davidlake/RC-Aerobatic-Acquisition-System/Desktop App/Images/FlightTrack.png

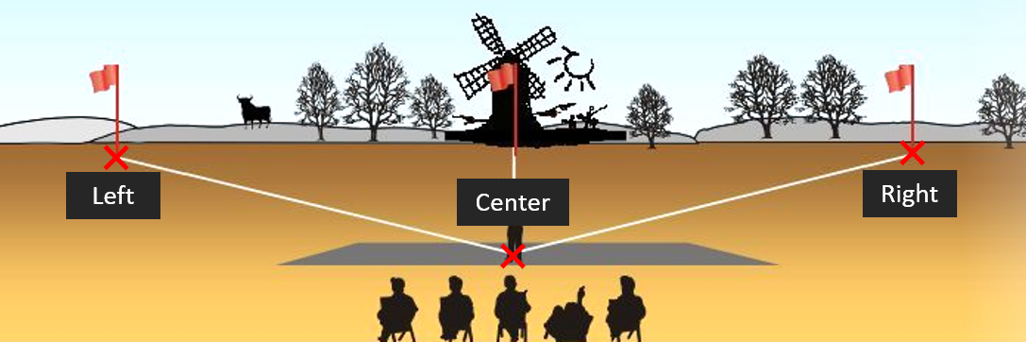
Desktop App/Images/FlightTrack.png
