davidlake/RC-Aerobatic-Acquisition-System/README.md

# RC-Aerobatic-Acquisition-System
System to determine orientation and position of aerobatic RC models
