davidlake/RC-Aerobatic-Acquisition-System/Envelope/Documentation plastic screws/Links.txt

https://webcatalog.epidor.com/es/category/tornillo-rosca-para-plastico-id-36751
https://www.indexfix.com/docs/FT_ROS_es.pdf
