davidlake/RC-Aerobatic-Acquisition-System/Components datasheets/Bluetooth HC06/Schematics/Schematic.PNG

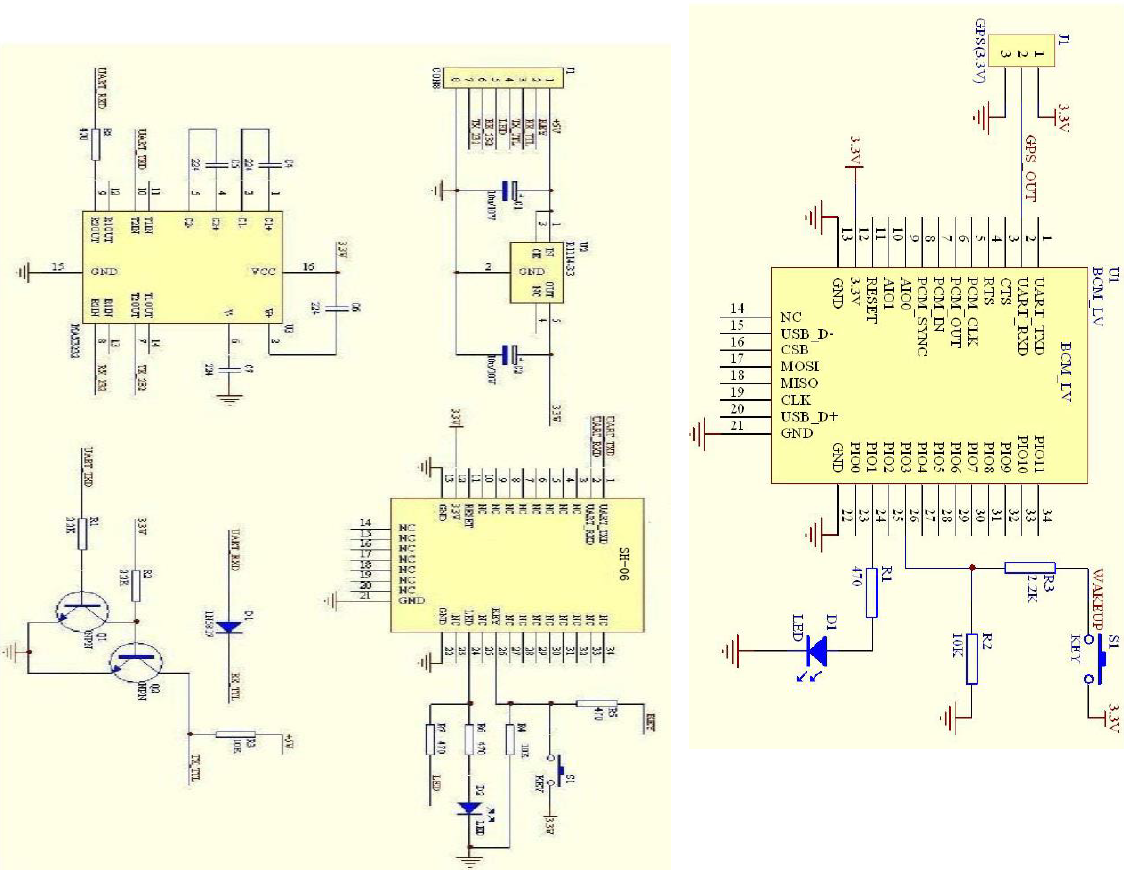
Components datasheets/Bluetooth HC06/Schematics/Schematic.PNG
