davidlake/RC-Aerobatic-Acquisition-System/Components datasheets/ublox NEO M8N/Schematic/Schematic modulo.PNG

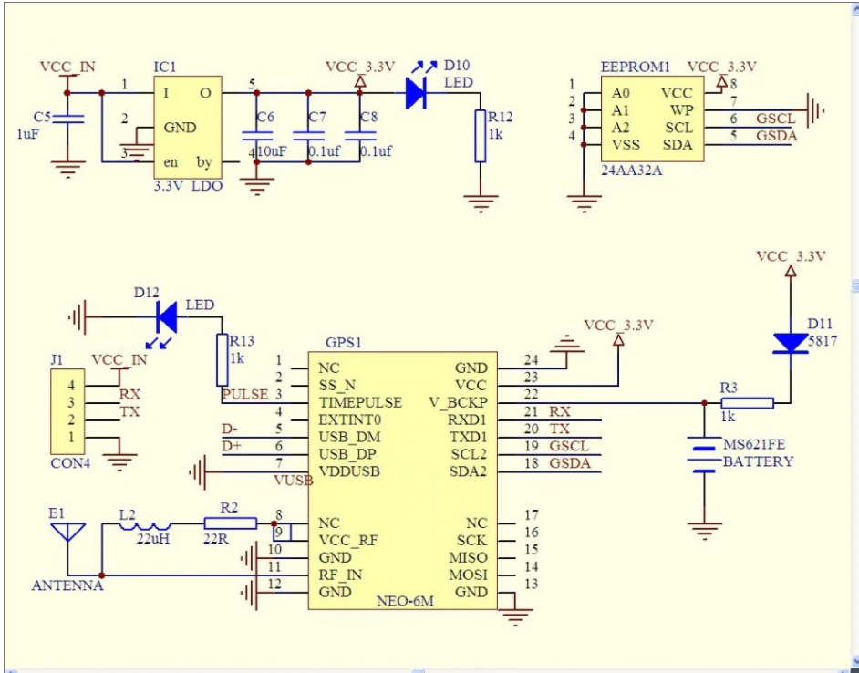
Components datasheets/ublox NEO M8N/Schematic/Schematic modulo.PNG
