davidlake/RC-Aerobatic-Acquisition-System/Components datasheets/W25Q64V/Pinout.JPG

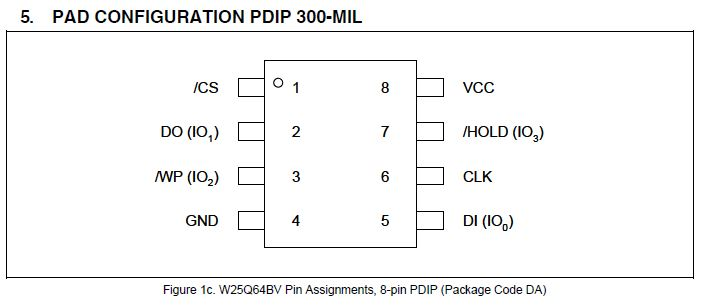
Components datasheets/W25Q64V/Pinout.JPG
