davidlake/RC-Aerobatic-Acquisition-System/Components datasheets/GY-63 MS5611/General info.JPG

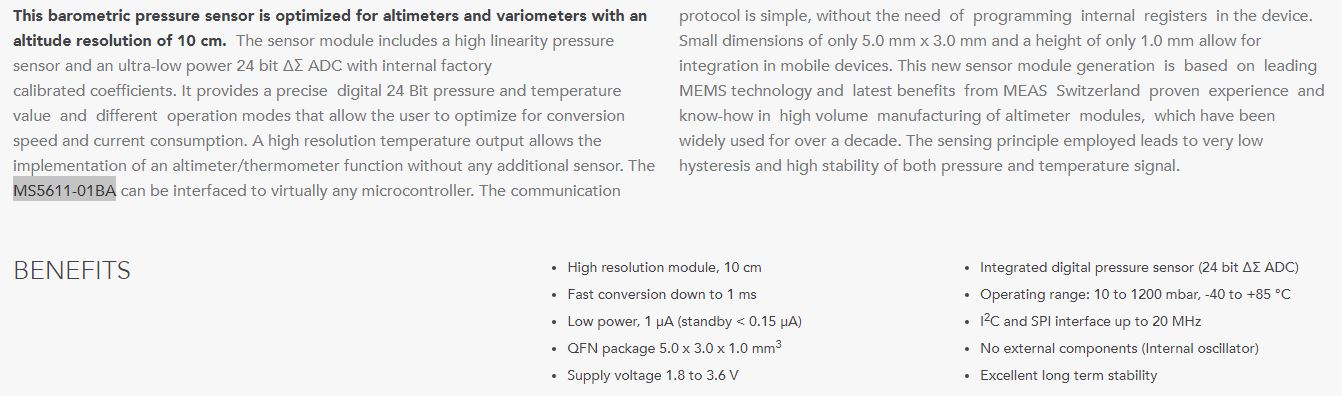
Components datasheets/GY-63 MS5611/General info.JPG
