davidlake/RC-Aerobatic-Acquisition-System/Components datasheets/W25Q64V/Pin description.JPG

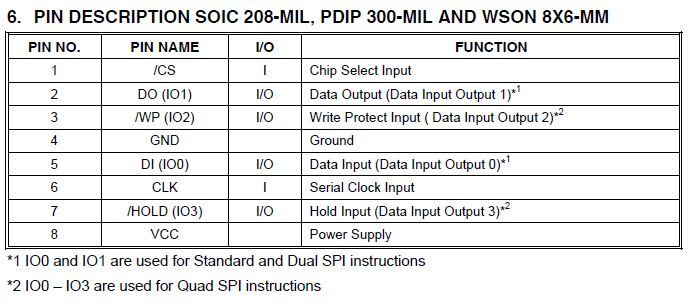
Components datasheets/W25Q64V/Pin description.JPG
