davidlake/RC-Aerobatic-Acquisition-System/Envelope/3D models/Assembly.step

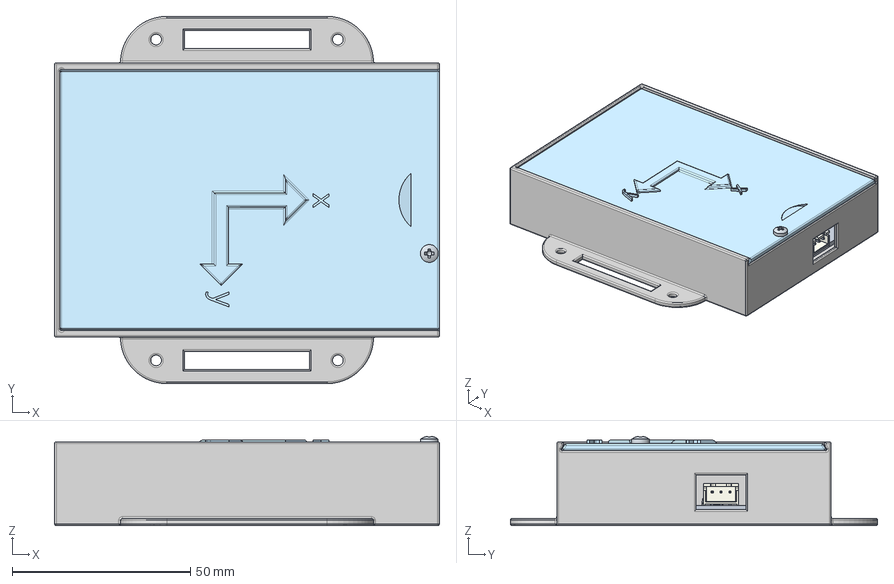
[picture p10: CAD file, 2021-08-31]
Envelope/3D models/Assembly.step
108.0 x 103.0 x 25.0 mm
PZ Pan head screw M2.5x0.45 x 4 x 5
Cap
Envelope box
