davidlake/RC-Aerobatic-Acquisition-System/Desktop App/AircraftModels/Gemini.stl

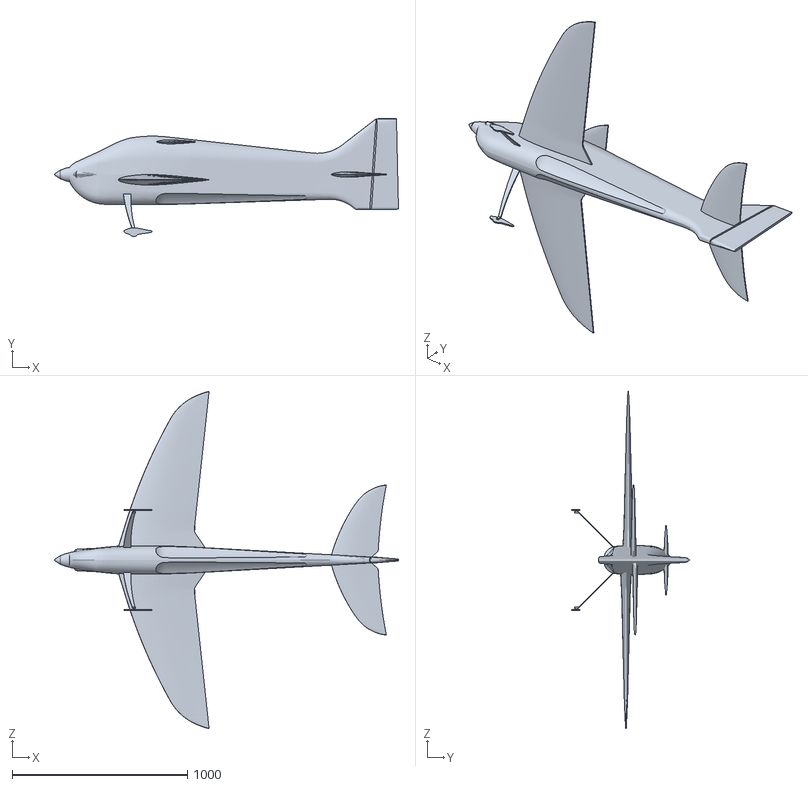
[picture p11: CAD file, 2021-09-01]
Desktop App/AircraftModels/Gemini.stl
1965.1 x 674.1 x 1928.2
