davidlake/RC-Aerobatic-Acquisition-System/Desktop App/Functions/STLRead/femur.stl

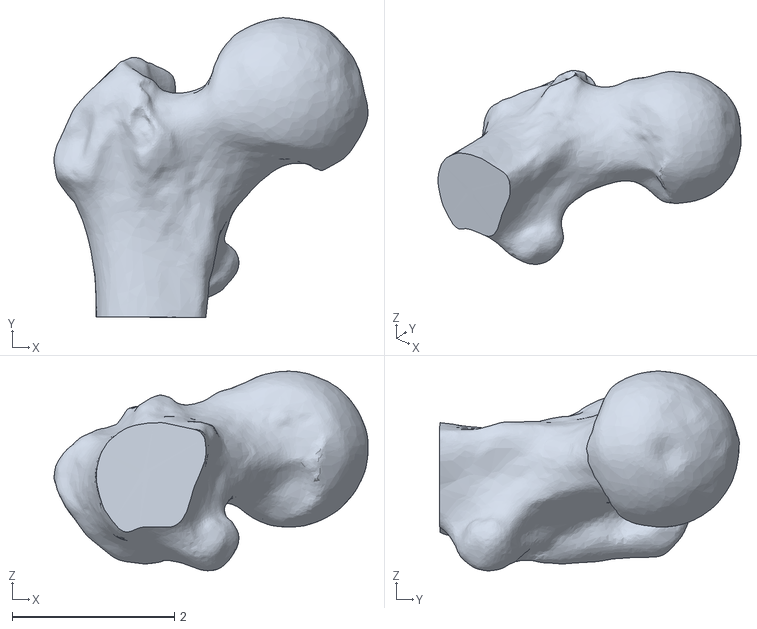
[picture p12: CAD file, 2021-08-28]
Desktop App/Functions/STLRead/femur.stl
3.87 x 3.70 x 2.46
