davidlake/RC-Aerobatic-Acquisition-System/Desktop App/UserData/AircraftModels/Aircraft surface.stl

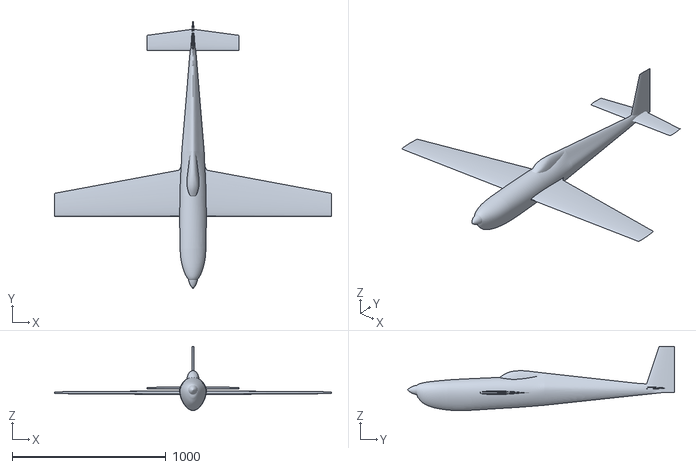
[picture p13: CAD file, 2021-08-28]
Desktop App/UserData/AircraftModels/Aircraft surface.stl
1800.0 x 1735.0 x 417.2
