davidlake/RC-Aerobatic-Acquisition-System/Envelope/3D models/Cap.step

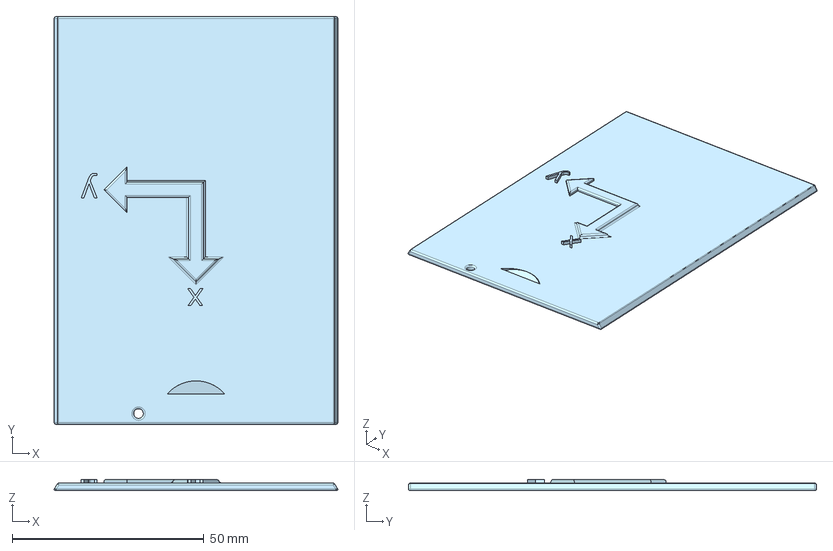
[picture p14: CAD file, 2021-08-31]
Envelope/3D models/Cap.step
74.1 x 106.5 x 3.00 mm
