davidlake/RC-Aerobatic-Acquisition-System/Hardware/F3A_Board.step

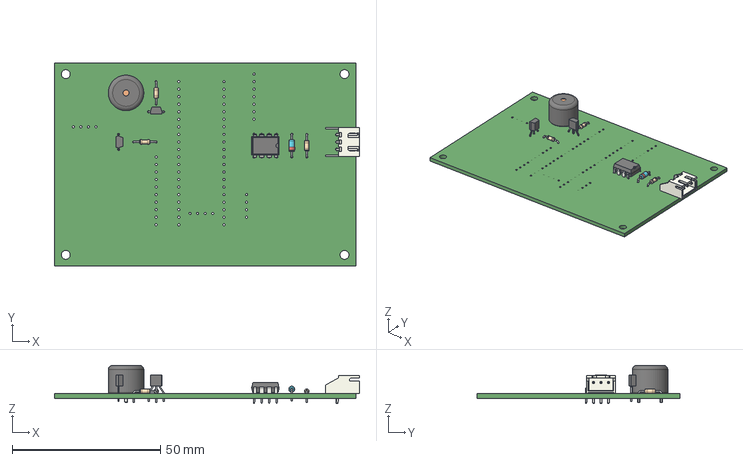
[picture p15: CAD file, 2021-08-26]
Hardware/F3A_Board.step
102.8 x 68.6 x 12.9 mm
