davidlake/RC-Aerobatic-Acquisition-System/Envelope/3D models/Envelope box.step

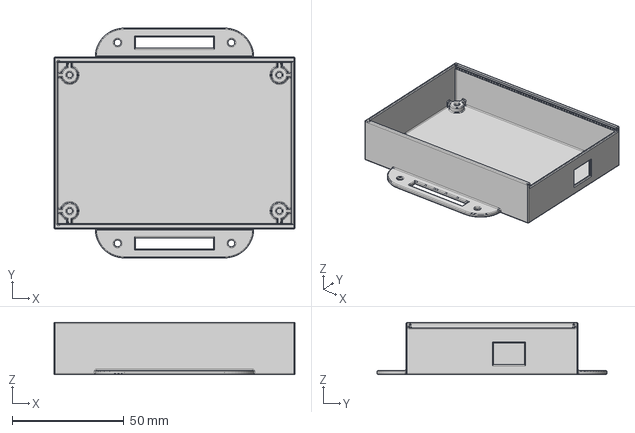
[picture p16: CAD file, 2021-08-31]
Envelope/3D models/Envelope box.step
108.0 x 103.0 x 23.5 mm
