davidlake/RC-Aerobatic-Acquisition-System/Hardware/Plots/F3A_Board.pdf

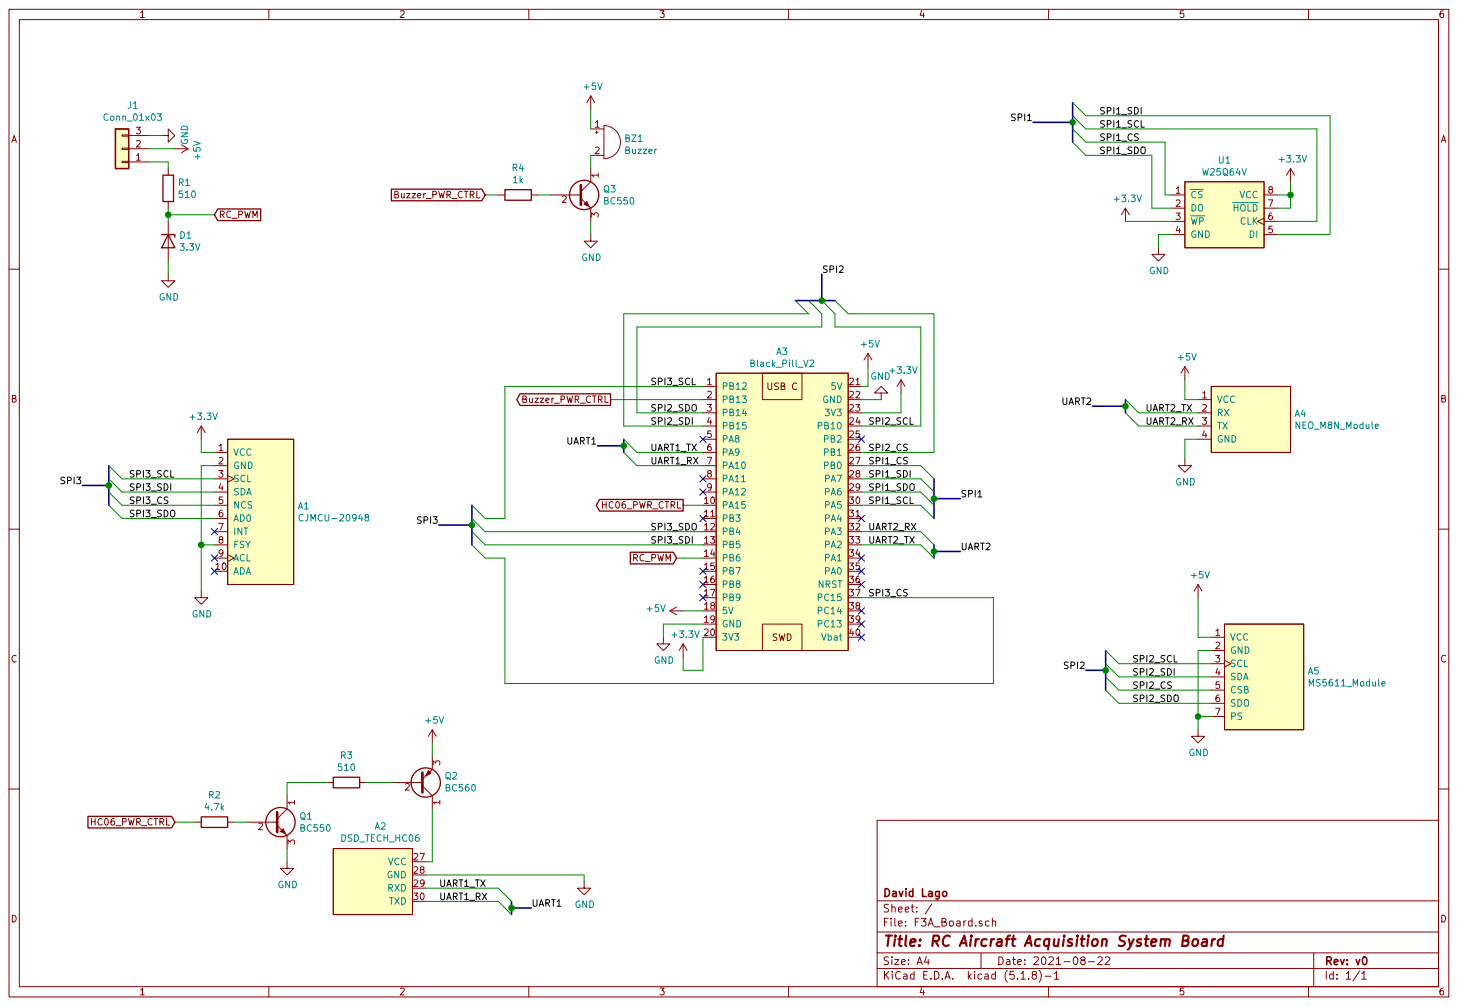
[picture p17: page 1]

File: F3A_Board.sch Sheet: / David Lago

Id: 1/1 Title: RC Aircraft Acquisition System Board
