davidlake/RC-Aerobatic-Acquisition-System/Envelope/Drawings/Assembly.pdf

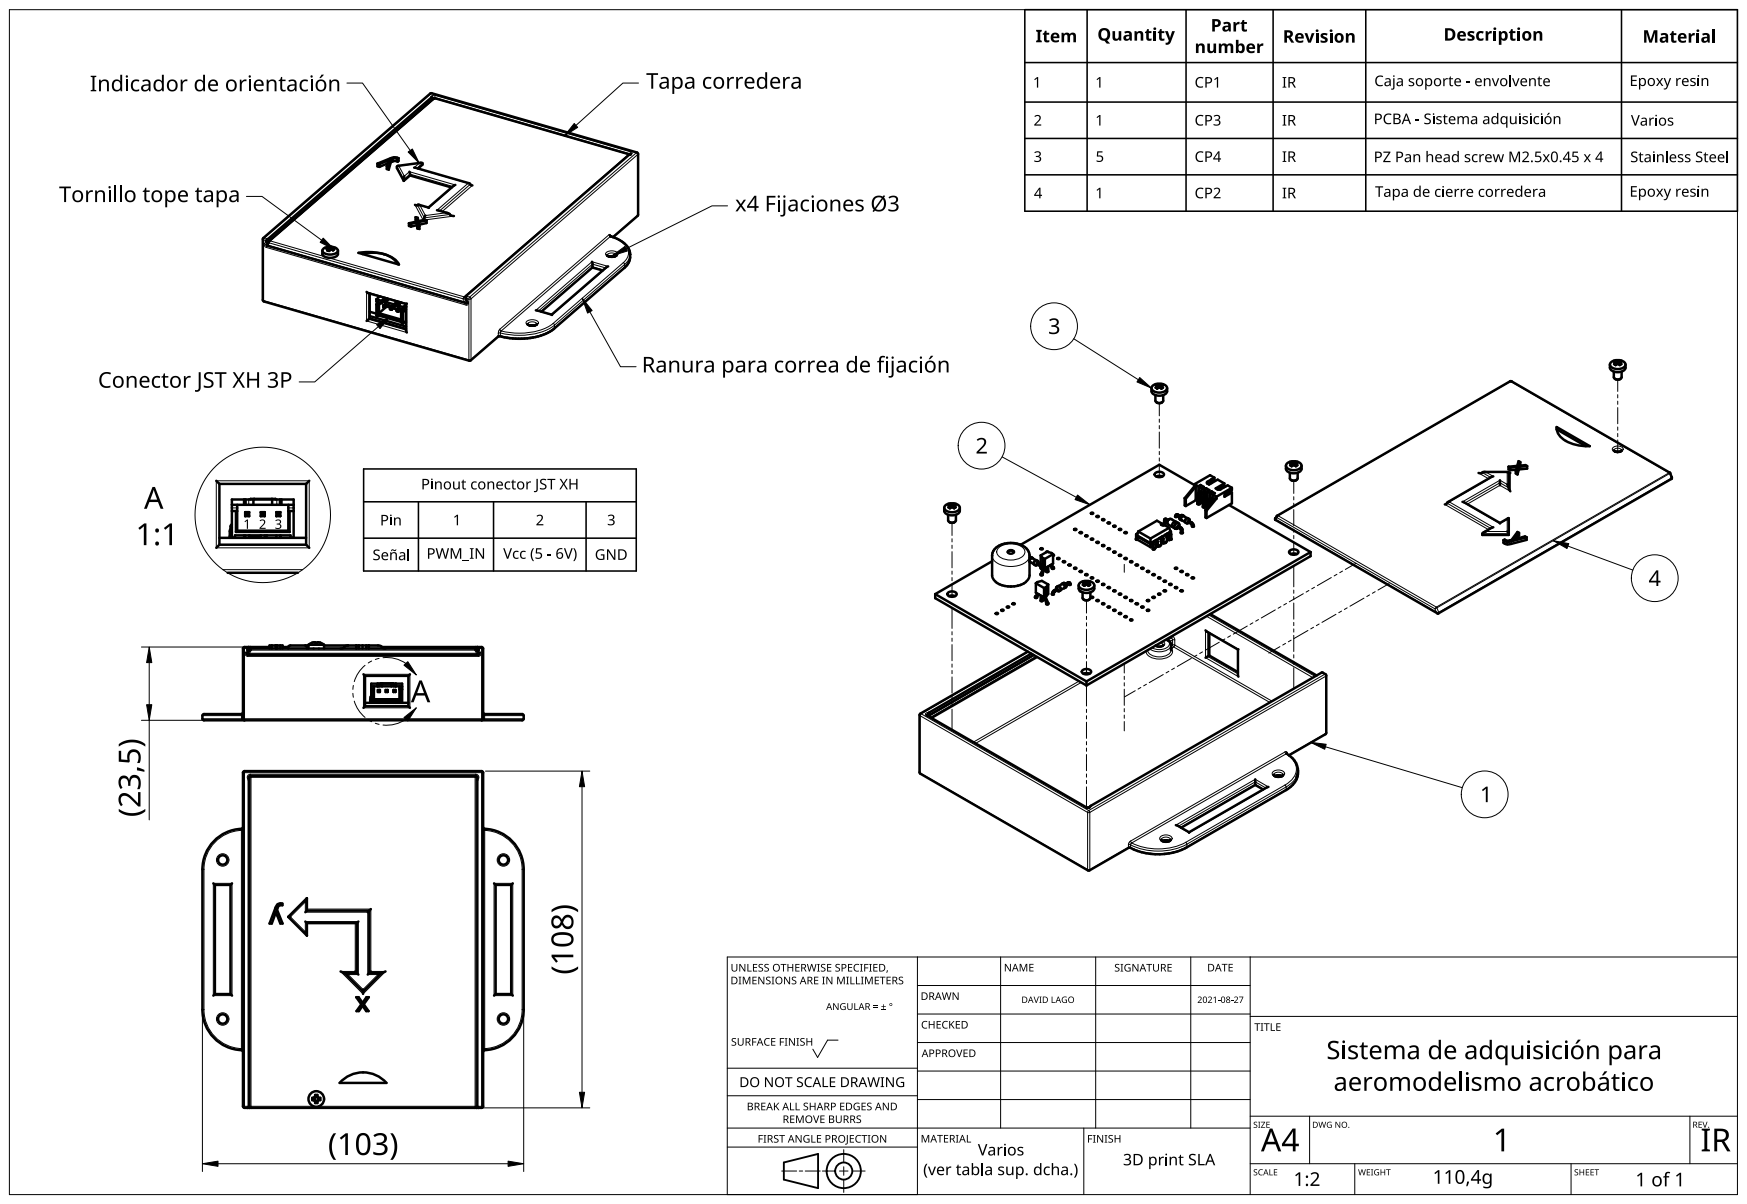
[picture p18: page 1]
