davidlake/RC-Aerobatic-Acquisition-System/Envelope/Drawings/Cap.pdf

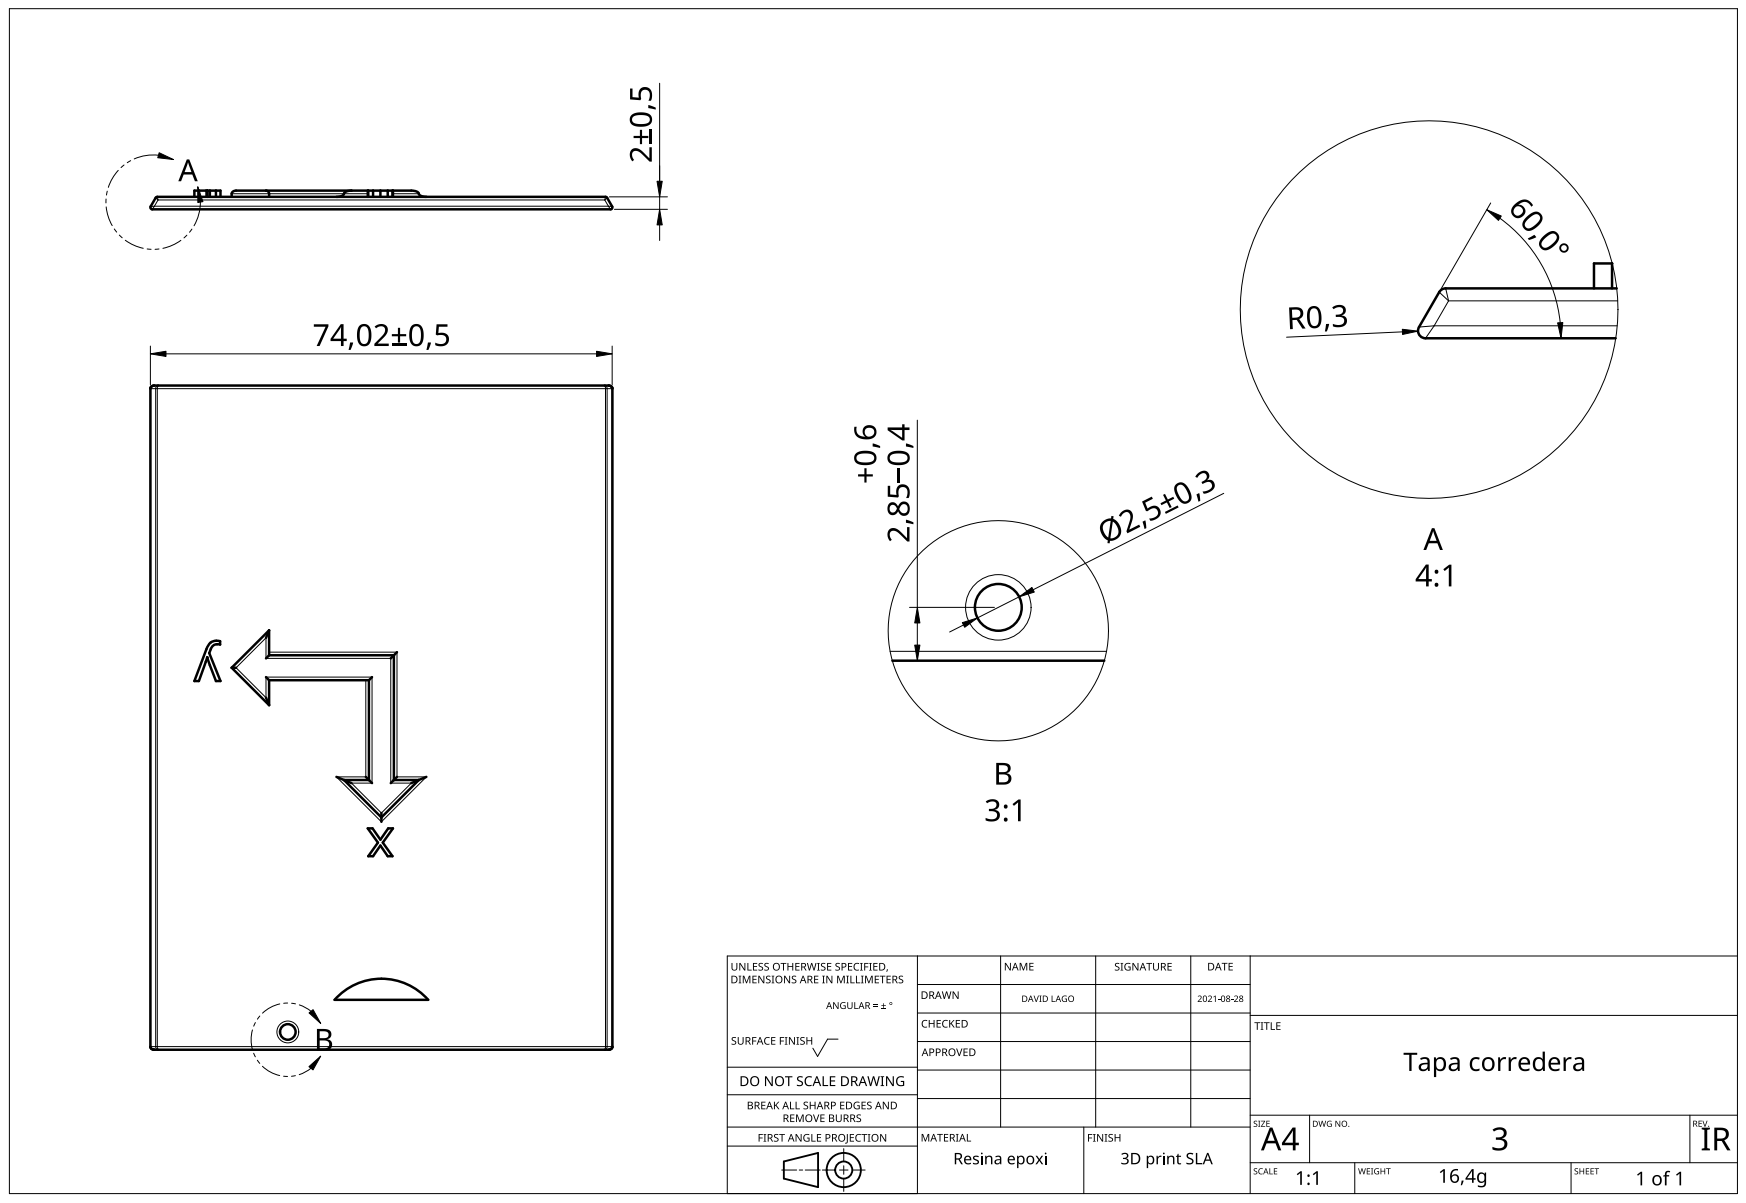
[picture p19: page 1]
