davidlake/RC-Aerobatic-Acquisition-System/Envelope/Drawings/Envelope box.pdf

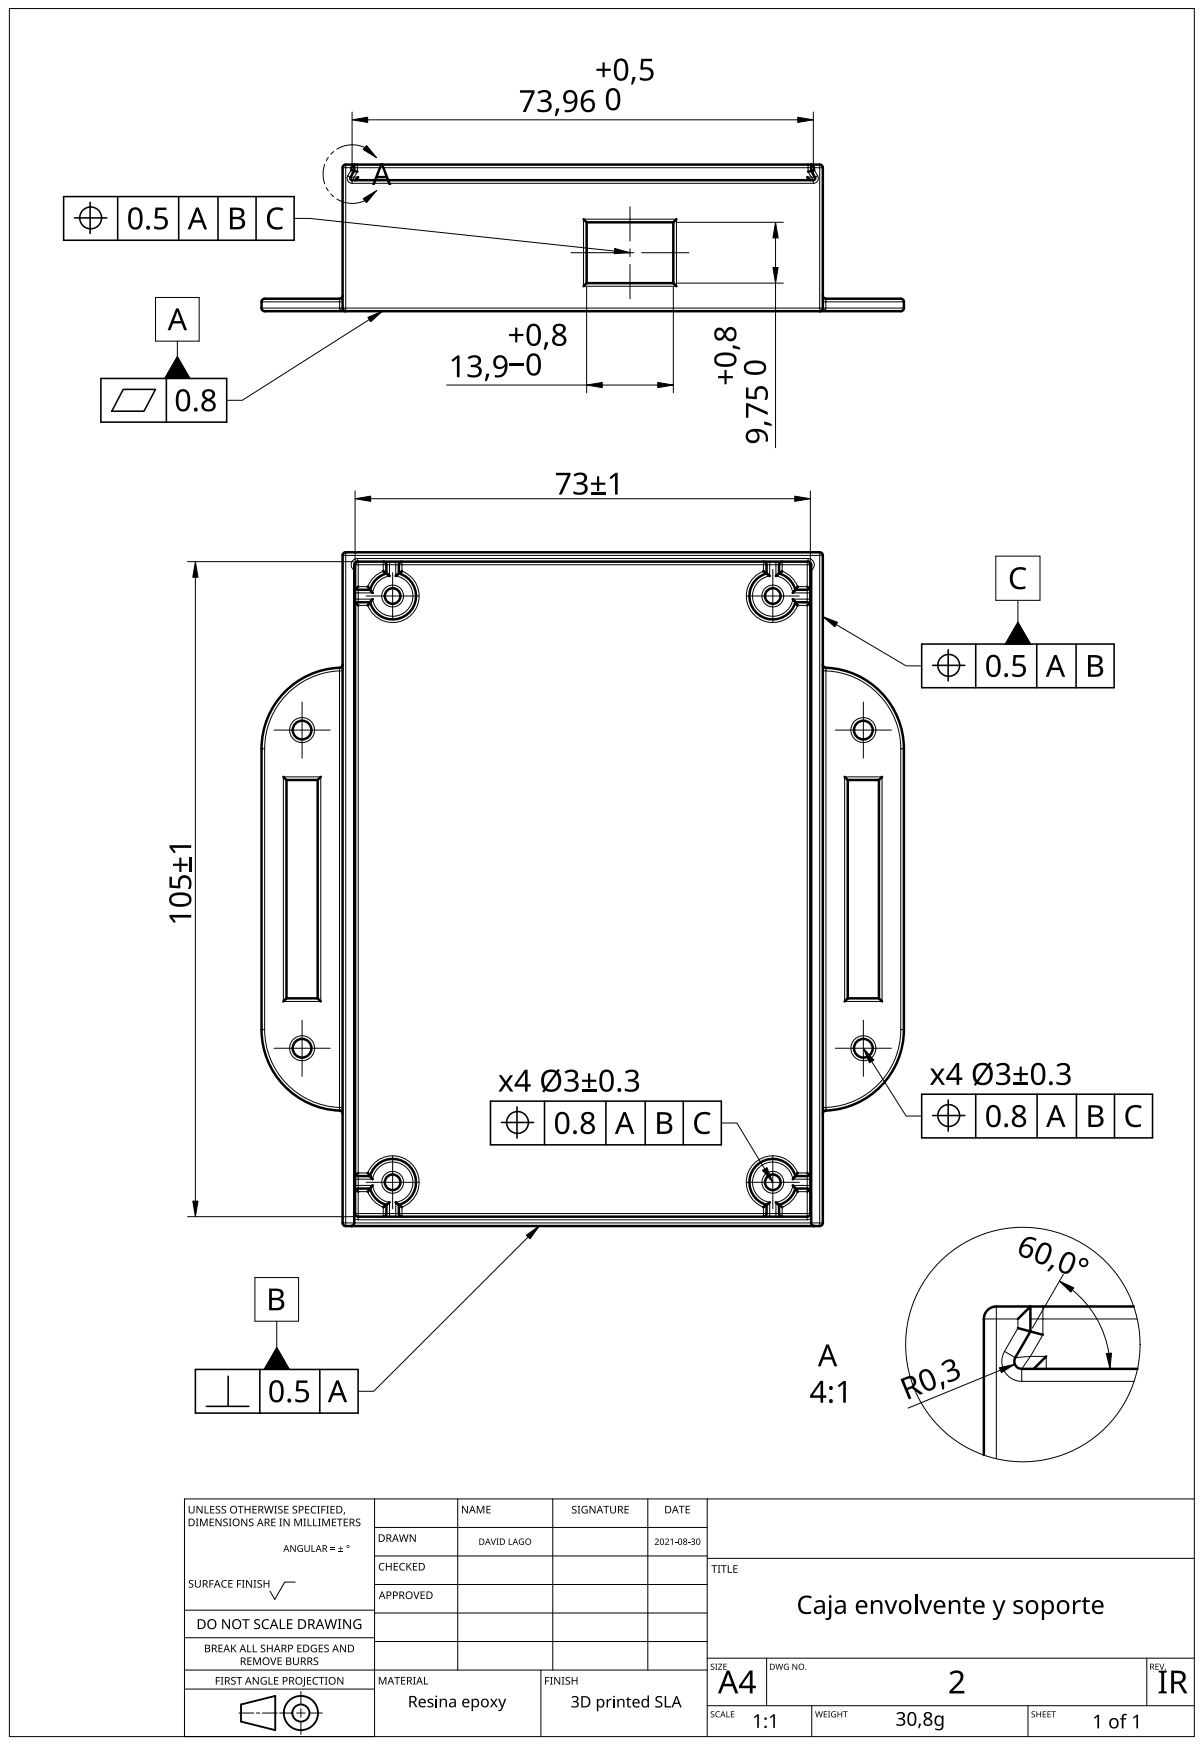
[picture p20: page 1]
