davidlake/RC-Aerobatic-Acquisition-System/Spice simulation/HC06_npn_pnp.asc

BC556B: pnp
Q1: npn; BC550C
R1: res; 510
R2: res; 4700
R3: res; 125
V1: voltage; 3.3
V2: voltage; 5
Named nets: 0
.tran 2
.lib C:\\Users\\dlago\\Documents\\LTspiceXVII\\lib\\europe.lib
