davidlake/RC-Aerobatic-Acquisition-System/Hardware/F3A_Board.kicad_pcb

## KiCad design Hardware/F3A_Board.kicad_pcb (2021-08-27)

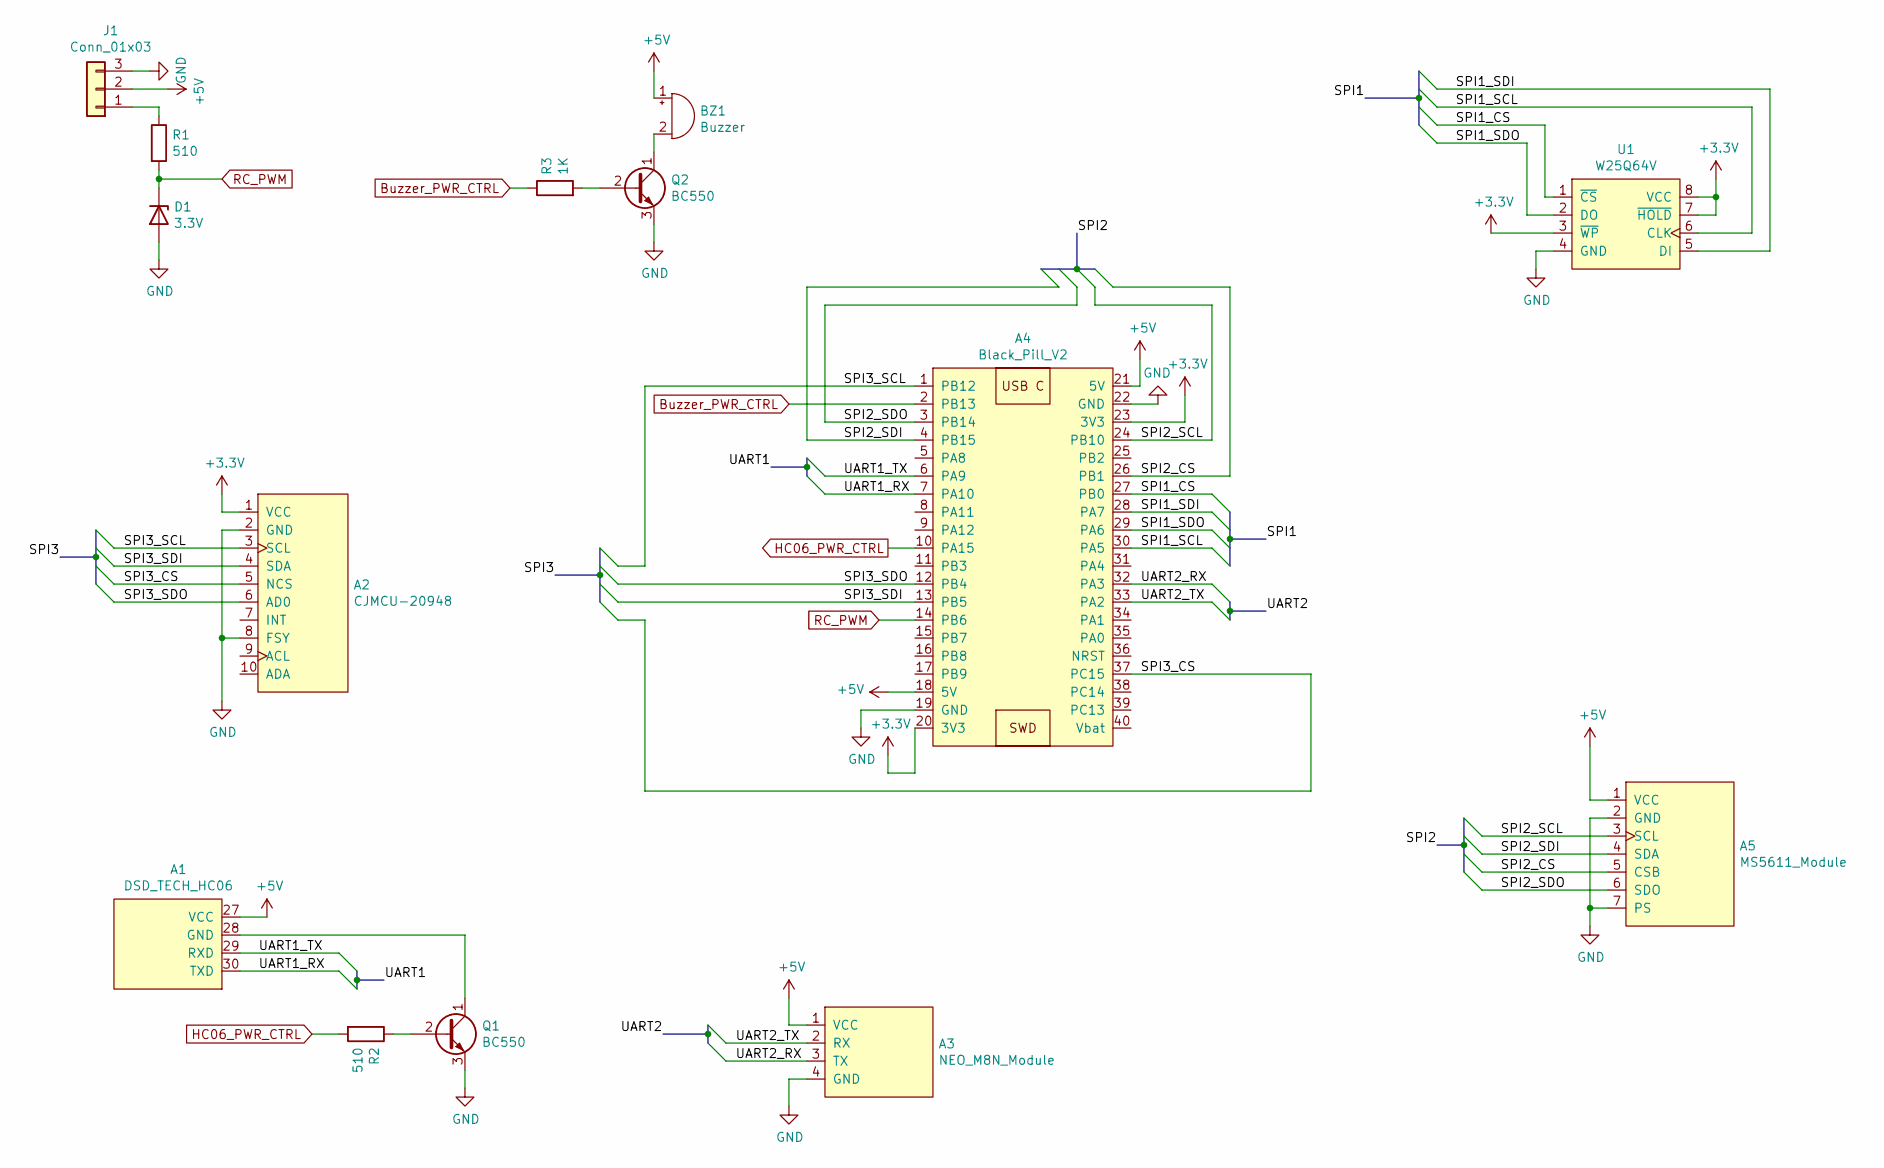
[picture p21: schematic F3A_Board.sch, RC Aircraft Acquisition System Board]

Parts:
A1: DSD_TECH_HC06
A2: CJMCU-20948; CJMCU_20948
A3: NEO_M8N_Module
A4: Black_Pill_V2
A5: MS5611_Module
BZ1: Buzzer; Buzzer_12x9.5RM7.6
D1: 3.3V; D_DO-35_SOD27_P7.62mm_Horizontal
J1: Conn_01x03; JST_XH_S3B-XH-A-1_1x03_P2.50mm_Horizontal
Q1, Q2: BC550; TO-92S_Wide
R1, R2: 510; R_Axial_DIN0204_L3.6mm_D1.6mm_P7.62mm_Horizontal
R3: 1K; R_Axial_DIN0204_L3.6mm_D1.6mm_P7.62mm_Horizontal
U1: W25Q64V; DIP-8_W7.62mm

Connections:
+3V3: A2.1 (VCC), A4.20 (3V3), A4.23 (3V3), U1.3 (~WP), U1.7 (~HOLD), U1.8 (VCC)
+5V: A1.27 (VCC), A3.1 (VCC), A4.18 (5V), A4.21 (5V), A5.1 (VCC), BZ1.1 (-), J1.2
/SPI1_CS: A4.27 (PB0), U1.1 (~CS)
/SPI1_SCL: A4.30 (PA5), U1.6 (CLK)
/SPI1_SDI: A4.28 (PA7), U1.5 (DI)
/SPI1_SDO: A4.29 (PA6), U1.2 (DO)
/SPI2_CS: A4.26 (PB1), A5.5 (CSB)
/SPI2_SCL: A4.24 (PB10), A5.3 (SCL)
/SPI2_SDI: A4.4 (PB15), A5.4 (SDA)
/SPI2_SDO: A4.3 (PB14), A5.6 (SDO)
/SPI3_CS: A2.5 (NCS), A4.37 (PC15)
/SPI3_SCL: A2.3 (SCL), A4.1 (PB12)
/SPI3_SDI: A2.4 (SDA), A4.13 (PB5)
/SPI3_SDO: A2.6 (AD0), A4.12 (PB4)
/UART1_RX: A1.30 (TXD), A4.7 (PA10)
/UART1_TX: A1.29 (RXD), A4.6 (PA9)
/UART2_RX: A3.3 (TX), A4.32 (PA3)
/UART2_TX: A3.2 (RX), A4.33 (PA2)
Buzzer_PWR_CTRL: A4.2 (PB13), R3.1
GND: A2.2 (GND), A2.8 (FSY), A3.4 (GND), A4.19 (GND), A4.22 (GND), A5.2 (GND), A5.7 (PS), D1.2 (A), J1.3, Q1.3 (E), Q2.3 (E), U1.4 (GND)
HC06_PWR_CTRL: A4.10 (PA15), R2.2
unnamed: A1.28 (GND), Q1.1 (C)
unnamed: BZ1.2 (+), Q2.1 (C)
unnamed: J1.1, R1.1
unnamed: Q1.2 (B), R2.1
unnamed: Q2.2 (B), R3.2
RC_PWM: A4.14 (PB6), D1.1 (K), R1.2

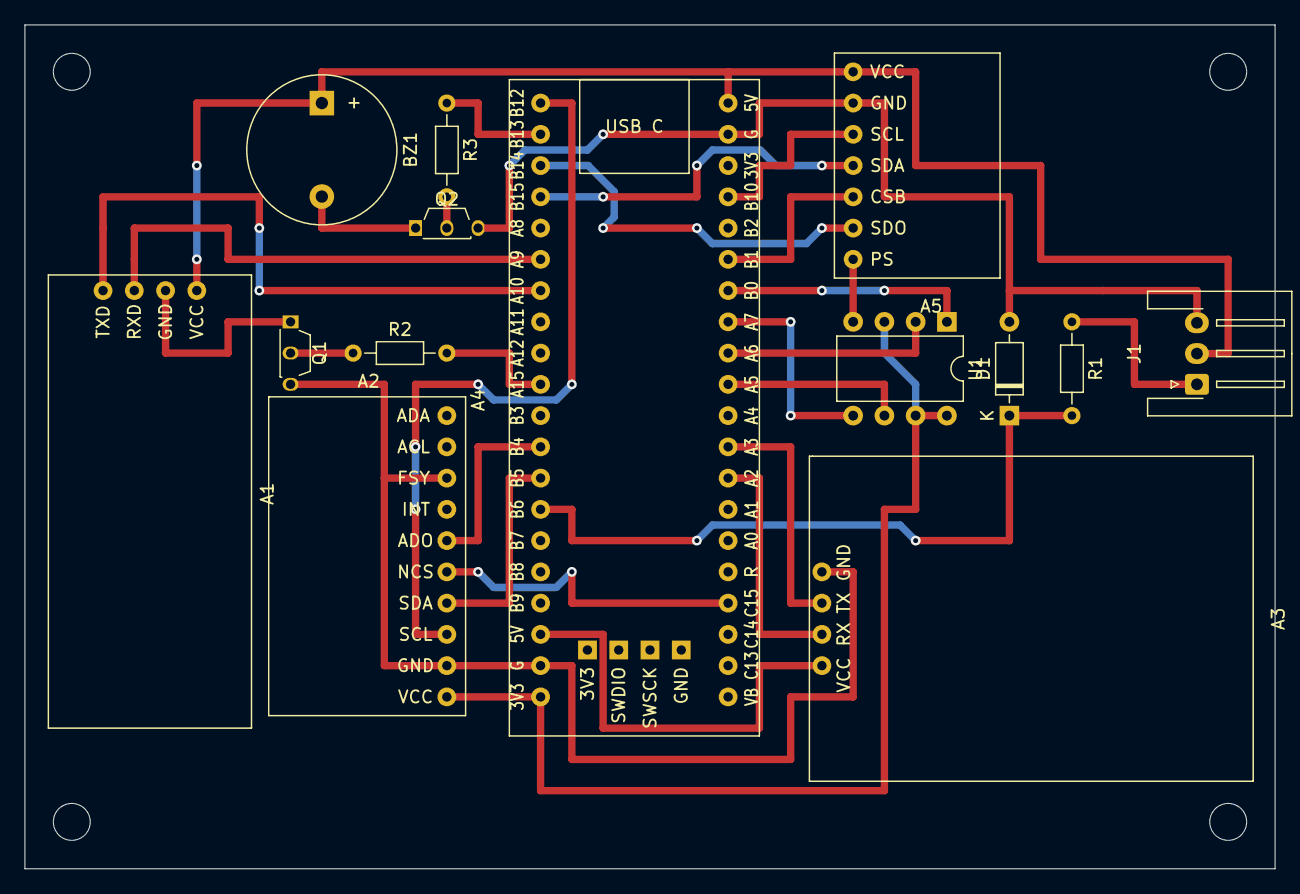
[picture p22: board F3A_Board.kicad_pcb from above]

Board: 2 copper layers, 101.6 x 68.6 mm, 14 parts (0 on the bottom side), 27 nets.
