davidlake/RC-Aerobatic-Acquisition-System/Firmware/Core/Src/main.c

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
/* Includes ------------------------------------------------------------------*/
#include "main.h"

/* USER CODE BEGIN Includes */
#include <stdio.h>
#include <string.h>
#include "HelperFcns.h"
#include "FIFO.h"
#include "MS5611.h"
#include "UBLOXM8N.h"
#include "ICM20948.h"
#include "HC06.h"
#include "w25qxx.h"
#include "Buzzer.h"
#include "FlashMemory.h"
/* USER CODE END Includes */

/* USER CODE BEGIN PTD */
typedef enum _State_FSM
{
	Initialize_State,
	NonCalibrated_State,
	Calibrated_State,
	DataLogging_State,
} State_FSM;
typedef enum _Event_FSM
{
	Minus100_to_Zero_Event,
	Zero_to_Plus100_Event,
	Plus100_to_Zero_Event,
	Zero_to_Minus100_Event,
	Minus100_to_Plus100_Event,
	Plus100_to_Minus100_Event,
	Nothing_Event,
	BLT_Set_UsrData_Event,
	BLT_Get_UsrData_Event,
	BLT_Get_SensorData_Event,
	BLT_EraseMemory,
} Event_FSM;
typedef enum _SwitchPosition //switch position RC transceiver
{
	Minus100,
	Zero,
	Plus100,
	NonValid,
} SwitchPosition;
typedef struct _RCReceiverSignal
{
	SwitchPosition current_SwitchPosition;
	SwitchPosition old_SwitchPosition;
	uint32_t PWM_f; //frequency reading
	float PWM_DC; //duty cycle reading
	uint32_t TIM_IC_Val1; //used for frequency and DC calculation
	uint32_t TIM_IC_Val2; //used for frequency and DC calculation
	float PWM_DC_Thre; //Threshold for PWM change detection
	float PWM_DC_Minus100; //predefined DC value for -100 switch position
	float PWM_DC_Plus100; //predefined DC value for +100 switch position
	float PWM_DC_Zero; //predefined DC value for zero switch position
} RCReceiverSignal;

/* USER CODE END PTD */

SPI_HandleTypeDef hspi1;
SPI_HandleTypeDef hspi2;
SPI_HandleTypeDef hspi3;

TIM_HandleTypeDef htim3;
TIM_HandleTypeDef htim4;
TIM_HandleTypeDef htim9;
TIM_HandleTypeDef htim11;

UART_HandleTypeDef huart1;
UART_HandleTypeDef huart2;

/* USER CODE BEGIN PV */
//MS5611 instance
MS5611_DEVICE MS5611_Dev;
//UBLOXM8N instance
UBLOXM8N_DEVICE UBLOXM8N_Dev;
//ICM20948 instance
ICM20948_DEVICE ICM20948_Dev;
//SPI FLASH instance
W25Qxx_DEVICE W25Q64V_Dev;
//HC08 instance
HC06_DEVICE HC06_Dev;
//Buzzer
BUZZER_DEVICE BUZZER_Dev;

//FSM variables
State_FSM state_FSM; //stores current FSM state
Event_FSM event_FSM; //stores new FSM event
fifo_t queue_FSM; //stores FSm events

//Other global variables
uint8_t dataBuffer[132]; //Data buffer (holds all sensor data from 1 sampling period: 132 bytes)
uint32_t nSamples; //variable that stores total samples during the full recording
uint8_t deviceName[50]; //stores the device name. Max 50 characters
RCReceiverSignal RCReceiverS; //variable that stores FM receiver signal info and TIM_IC intermediate values
uint8_t HC06_Rx_CmdBuffer[6]; //stores commands coming via usart through the bluetooth module
uint8_t HC06_Tx_UsrData[57]; //stores general device information data to transmit
uint8_t HC06_Tx_SensorData[4096]; //stores 1 4K sector of sensor data from memory to transmit

//Debug variables to count program cycles
uint32_t cycles1; uint32_t cycles2; uint32_t cyclesDiff;
uint8_t testVar;

/* USER CODE END PV */

void SystemClock_Config(void);
static void MX_GPIO_Init(void);
static void MX_USART1_UART_Init(void);
static void MX_SPI1_Init(void);
static void MX_SPI2_Init(void);
static void MX_SPI3_Init(void);
static void MX_USART2_UART_Init(void);
static void MX_TIM9_Init(void);
static void MX_TIM11_Init(void);
static void MX_TIM4_Init(void);
static void MX_TIM3_Init(void);
/* USER CODE BEGIN PFP */

void getNextEvent(void);
void getDeviceInfo(void);
void setDeviceInfo(void);

/* USER CODE END PFP */

/**
  * @brief  The application entry point.
  * @retval int
  */
int main(void)
{
  /* MCU Configuration--------------------------------------------------------*/

  /* Reset of all peripherals, Initializes the Flash interface and the Systick. */
  HAL_Init();

  /* Configure the system clock */
  SystemClock_Config();

  /* Initialize all configured peripherals */
  MX_GPIO_Init();
  MX_USART1_UART_Init();
  MX_SPI1_Init();
  MX_SPI2_Init();
  MX_SPI3_Init();
  MX_USART2_UART_Init();
  MX_TIM9_Init();
  MX_TIM11_Init();
  MX_TIM4_Init();
  MX_TIM3_Init();
  /* USER CODE BEGIN 2 */

  //Initialize FSMs & other global variables
  state_FSM = Initialize_State;
  queue_FSM = fifo_create(10, sizeof(Event_FSM));

  RCReceiverS.PWM_DC_Minus100 = 12.93;
  RCReceiverS.PWM_DC_Plus100 = 7.33;
  RCReceiverS.PWM_DC_Zero = 10.13;
  RCReceiverS.PWM_DC_Thre = 0.7;

  //Initialize CS lines for SPI communications
  HAL_GPIO_WritePin(W25Q64_SPI1_CS_GPIO_Port, W25Q64_SPI1_CS_Pin, GPIO_PIN_SET);
  HAL_GPIO_WritePin(MS5611_SPI2_CS_GPIO_Port, MS5611_SPI2_CS_Pin, GPIO_PIN_SET);
  HAL_GPIO_WritePin(ICM20948_SPI3_CS_GPIO_Port, ICM20948_SPI3_CS_Pin, GPIO_PIN_SET);

  //Initialize user indicators
  HAL_GPIO_WritePin(LED_GPIO_Port, LED_Pin, GPIO_PIN_SET); //turn off led
  BUZZER_Init(&BUZZER_Dev, Buzzer_PWR_CTRL_GPIO_Port, Buzzer_PWR_CTRL_Pin, &htim3);

  //Initialize MS5611
  MS5611_Init_Device(&MS5611_Dev, &hspi2, MS5611_SPI2_CS_GPIO_Port, MS5611_SPI2_CS_Pin);
  MS5611_Set_Config(&MS5611_Dev, OSR_4096, OSR_4096);

  //Initialize ICM20948
  ICM20948_Init_Device(&ICM20948_Dev, &hspi3, ICM20948_SPI3_CS_GPIO_Port ,ICM20948_SPI3_CS_Pin);
  ICM20948_Set_Sensors_Default_Config(&ICM20948_Dev);

  //Initialize UBLOXM8N
  UBLOXM8N_Init_Device(&UBLOXM8N_Dev, &huart2);

  //Initialize W25Q64V
  W25qxx_Init_Device(&W25Q64V_Dev, &hspi1, W25Q64_SPI1_CS_GPIO_Port, W25Q64_SPI1_CS_Pin);

  //Initialize HC06
  HC06_Init_Device(&HC06_Dev, &huart1, HC06_PWR_CTRL_GPIO_Port, HC06_PWR_CTRL_Pin);
  //HC06_PowerON(&HC06_Dev);
  //HAL_Delay(500);
  //HC06_ConfigBaudRate(&HC06_Dev, BR_115200);

  //Debug wires
  HAL_GPIO_WritePin(Test_GPS_GPIO_Port, Test_GPS_Pin, GPIO_PIN_RESET);
  HAL_GPIO_WritePin(Test_IMU_GPIO_Port, Test_IMU_Pin, GPIO_PIN_RESET);
  HAL_GPIO_WritePin(Test_Baro_GPIO_Port, Test_Baro_Pin, GPIO_PIN_RESET);
  HAL_GPIO_WritePin(Test_Flash_GPIO_Port, Test_Flash_Pin, GPIO_PIN_RESET);

  /* USER CODE END 2 */

  /* Infinite loop */
  /* USER CODE BEGIN WHILE */
  while (1)
  {
	  getNextEvent();
	  switch (state_FSM)
	  {
	  case Initialize_State:
		  //Disable GPS IT uart
		  __HAL_UART_DISABLE_IT(&huart2, UART_IT_IDLE);
		  //Read device info stored in external flash and store it in MCU RAM: name and nSamples
		  getDeviceInfo();
		  //Initialization buzzer sound 2beeps + long beep
		  BUZZER_nBeeps_Blck(&BUZZER_Dev, 2);
		  BUZZER_TurnON_Blck(&BUZZER_Dev, 500);
		  //Start measuring PWM signal from receiver (tim4 ic mode)
		  HAL_TIM_IC_Start_IT(&htim4, TIM_CHANNEL_1);
		  HAL_TIM_IC_Start_IT(&htim4, TIM_CHANNEL_2);
		  //BLE power on and enable idle line interrupt on its usart
		  HC06_PowerON(&HC06_Dev);
		  //__HAL_UART_ENABLE_IT(&huart1, UART_IT_IDLE);
		  HAL_UART_Receive_IT(&huart1, &HC06_Rx_CmdBuffer[0], 6);
		  //Change FSM state
		  state_FSM = NonCalibrated_State;
		  break;
	  case NonCalibrated_State:
		  switch (event_FSM)
		  {
		  case Minus100_to_Zero_Event: //User switch from A to B --> turn off bluetooth and start calibration
			  //Turn off BLE and stop HAL_UART_IT receptions
			  HC06_PowerOFF(&HC06_Dev);
			  HAL_UART_AbortReceive_IT(&huart1);
			  //Start led blinking
			  __HAL_TIM_SET_PRESCALER(&htim9,207); //200ms time
			  HAL_TIM_Base_Start_IT(&htim9);
			  //Beep 3 times
			  BUZZER_nBeeps_Blck(&BUZZER_Dev, 3);
			  //Perform calibration operations
			  MS5611_Calibrate_Altitude(&MS5611_Dev, 5);
			  //Enable GPS IT uart
			  __HAL_UART_ENABLE_IT(&huart2, UART_IT_IDLE);
			  //Stop led blinking and turn it off
			  HAL_TIM_Base_Stop_IT(&htim9);
			  HAL_GPIO_WritePin(LED_GPIO_Port, LED_Pin, GPIO_PIN_SET);
			  //Beep 3 times
			  BUZZER_nBeeps_Blck(&BUZZER_Dev, 3);
			  //Change FSM state
			  state_FSM = Calibrated_State;
			  break;
		  case BLT_Set_UsrData_Event: //Set device information request from PC app
			  //to be completed
			  HAL_UART_Receive_IT(&huart1, &HC06_Rx_CmdBuffer[0], 6);
			  break;
		  case BLT_Get_UsrData_Event: //Get device information request from PC app
			  HC06_Tx_UsrData[0] = W25Q64V_Dev.isErased; //1 = is erased
			  memcpy(&HC06_Tx_UsrData[1],&W25Q64V_Dev.written4KSectorCount,2); //max 4kSectorCount = 2048 (only 2 bytes required)
			  memcpy(&HC06_Tx_UsrData[3],&deviceName[0],50); //device name
			  memcpy(&HC06_Tx_UsrData[53],&nSamples,4); //number of recorded samples
			  HAL_UART_Transmit(&huart1, HC06_Tx_UsrData, 57, 100);
			  HAL_UART_Receive_IT(&huart1, &HC06_Rx_CmdBuffer[0], 6);
			  break;
		  case BLT_Get_SensorData_Event:; //Get sensor data request from PC app
			  uint32_t i = 0;
			  for (i=0; i<W25Q64V_Dev.written4KSectorCount; i++)
			  {
				  W25qxx_ReadSector(&W25Q64V_Dev, &HC06_Tx_SensorData[0], i, 0, 4096);
				  HAL_UART_Transmit(&huart1, &HC06_Tx_SensorData[0], 4096, 1000);
				  HAL_Delay(120);
			  }
			  HAL_UART_Receive_IT(&huart1, &HC06_Rx_CmdBuffer[0], 6);
			  break;
		  case BLT_EraseMemory:
			  W25qxx_EraseChip(&W25Q64V_Dev);
			  W25qxx_IsErased(&W25Q64V_Dev);
			  nSamples = 0;
			  uint8_t n = 0;
			  for (n=0; n<50; n++)
			  {
				  deviceName[n] = ' ';
			  }
			  setDeviceInfo();
			  HAL_UART_Receive_IT(&huart1, &HC06_Rx_CmdBuffer[0], 6);
			  break;
		  default:
			  break;
		  }
		  break;
	  case Calibrated_State:
		  switch (event_FSM)
		  {
		  case Zero_to_Plus100_Event: // --> erase flash and start recording sensors
			  //Stop beeping if is running and beep 2 times
			  BUZZER_Beep_Stop(&BUZZER_Dev);
			  BUZZER_nBeeps_Blck(&BUZZER_Dev, 2);
			  //Start led blinking
			  __HAL_TIM_SET_PRESCALER(&htim9,207); //200ms time
			  HAL_TIM_Base_Start_IT(&htim9);
			  //Erase flash memory if not empty
			  if (!W25qxx_IsErased(&W25Q64V_Dev))
			  {
				  W25qxx_EraseWrittenMemory(&W25Q64V_Dev);
			  }
			  //Clear the samples counter
			  nSamples = 0; //in MCU RAM
			  setDeviceInfo(); //in flash
			  //Stop led blinking and turn it off
			  HAL_TIM_Base_Stop_IT(&htim9);
			  HAL_GPIO_WritePin(LED_GPIO_Port, LED_Pin, GPIO_PIN_SET);
			  //Beep 2 times
			  BUZZER_nBeeps_Blck(&BUZZER_Dev, 2);
			  //Start acquisition timer
			  HAL_TIM_Base_Start_IT(&htim11);
			  //Change FSM state
			  state_FSM = DataLogging_State;
			  break;
		  case Zero_to_Minus100_Event: // --> go back to non calibrated state and turn bluetooth on
			  //Stop buzzer beeping if running
			  BUZZER_Beep_Stop(&BUZZER_Dev);
			  BUZZER_nBeeps_Blck(&BUZZER_Dev, 2);
			  BUZZER_TurnON_Blck(&BUZZER_Dev, 500);
			  //Disable GPS IT uart
			  __HAL_UART_DISABLE_IT(&huart2, UART_IT_IDLE);
			  //Turn on BLE
			  HC06_PowerON(&HC06_Dev);
			  //__HAL_UART_ENABLE_IT(&huart1, UART_IT_IDLE);
			  HAL_UART_Receive_IT(&huart1, &HC06_Rx_CmdBuffer[0], 6);
			  //Change FSM state
			  state_FSM = NonCalibrated_State;
			  break;
		  default: // --> by default keep looking if GPS got a fix position..
			  if ((UBLOXM8N_Dev.navResult == Fix)&&(BUZZER_Dev.itState)) //if GPS is fix and beep has not been stopped
			  {
				  BUZZER_Beep_Stop(&BUZZER_Dev);
			  }
			  else if ((UBLOXM8N_Dev.navResult != Fix)&&(!BUZZER_Dev.itState)) //if GPS is not fix and beep has not started
			  {
				  BUZZER_Beep_Start(&BUZZER_Dev, 200, 1000);
			  }
		  }
		  break;
	  case DataLogging_State:
		  switch (event_FSM)
		  {
		  case Plus100_to_Zero_Event:
			  //Stop acquisition timer
			  HAL_TIM_Base_Stop_IT(&htim11);
			  //Store device info in external flash and MCU RAM
			  setDeviceInfo(); //stores nSamples saved (and device name)
			  //Beep 3 times
			  BUZZER_nBeeps_Blck(&BUZZER_Dev, 3);
			  //Change FSM state
			  state_FSM = Calibrated_State;
			  break;
		  default:
			  break;
		  }
		  break;
	  default:
		  break;
	  }

    /* USER CODE END WHILE */

    /* USER CODE BEGIN 3 */
  }
  /* USER CODE END 3 */
}

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
/* USER CODE BEGIN 4 */

// Helper functions
void getNextEvent(void)
{
	if(!fifo_get(queue_FSM, &event_FSM)) //if no event available
	{
		event_FSM = Nothing_Event;
	}
}
void getDeviceInfo(void)
{
	//Read device name
	W25qxx_ReadBytes(&W25Q64V_Dev, &deviceName[0], 0x7FF000, 50); //address is first byte of last 4Ksector
	//Read nSamples stored
	uint8_t nSamplesU8[4];
	W25qxx_ReadBytes(&W25Q64V_Dev, &nSamplesU8[0], 0x7FF032, 4);
	nSamples = (nSamplesU8[0] | nSamplesU8[1]<<8 | nSamplesU8[2]<<16 | nSamplesU8[3]<<24);
	if (nSamples == 0xFFFFFFFF)
	{
		nSamples = 0;
	}
}
void setDeviceInfo(void)
{
	//Erase last sector where this type of info is stored
	W25qxx_Erase4KSector(&W25Q64V_Dev, 2047);
	//Write device name and nSamples
	uint8_t buffInfo[54];
	memcpy(&buffInfo[0],&deviceName[0],50); //device name
	memcpy(&buffInfo[50],&nSamples,4); //nSamples
	W25qxx_WritePage(&W25Q64V_Dev, &buffInfo[0], 32752, 0, 54); //first page of last sector
}

//Interrupt callbacks
void HAL_TIM_PeriodElapsedCallback(TIM_HandleTypeDef *htim)
{
	if (htim == &htim11) //acquisition trigger
	{
		//Read IMU
		ICM20948_Get_AGMT_RawData(&ICM20948_Dev);
		//Start conversion or read conversion result barometer
		if (MS5611_Dev.current_ADC_Var == Pressure)
		{
			MS5611_Read_ADC(&MS5611_Dev);
			MS5611_Init_ADC_Conv(&MS5611_Dev, Temperature);
			MS5611_Get_DeltaAltitude(&MS5611_Dev);
		}
		else if (MS5611_Dev.current_ADC_Var == Temperature)
		{
			MS5611_Read_ADC(&MS5611_Dev);
			MS5611_Init_ADC_Conv(&MS5611_Dev, Pressure);
		}
		//Fill data buffer and write external flash
		float2uint8(MS5611_Dev.deltaH, &dataBuffer[0], 1);
		float2uint8(ICM20948_Dev.sensorsDataProc.accelData.x, &dataBuffer[4], 1);
		float2uint8(ICM20948_Dev.sensorsDataProc.accelData.y, &dataBuffer[8], 1);
		float2uint8(ICM20948_Dev.sensorsDataProc.accelData.z, &dataBuffer[12], 1);
		float2uint8(ICM20948_Dev.sensorsDataProc.gyroData.x, &dataBuffer[16], 1);
		float2uint8(ICM20948_Dev.sensorsDataProc.gyroData.y, &dataBuffer[20], 1);
		float2uint8(ICM20948_Dev.sensorsDataProc.gyroData.z, &dataBuffer[24], 1);
		float2uint8(ICM20948_Dev.sensorsDataProc.magnetoData.x, &dataBuffer[28], 1);
		float2uint8(ICM20948_Dev.sensorsDataProc.magnetoData.y, &dataBuffer[32], 1);
		float2uint8(ICM20948_Dev.sensorsDataProc.magnetoData.z, &dataBuffer[36], 1);
		memcpy(&dataBuffer[40],UBLOXM8N_Dev.navData,92);
		W25Q64_WriteBytes(&W25Q64V_Dev, &dataBuffer[0], 132);
		//Increment samples counter
		nSamples++;
	}
	if (htim == &htim9) //status led
	{
		HAL_GPIO_TogglePin(LED_GPIO_Port, LED_Pin);
	}
	if (htim == &htim3) //buzzer
	{
		if (BUZZER_Dev.state) //if buzzer is ON
		{
			BUZZER_OFF(&BUZZER_Dev);
			__HAL_TIM_SET_PRESCALER(&htim3,BUZZER_Dev.miliON);
		}
		else //if buzzer is OFF
		{
			BUZZER_ON(&BUZZER_Dev);
			__HAL_TIM_SET_PRESCALER(&htim3,BUZZER_Dev.miliOFF);
		}
	}
}
void UART_IdleLineCallback(UART_HandleTypeDef *huart)
{
	if (huart == &huart2) //GNSS uart idle line detection
	{
		HAL_UART_Receive_IT(&huart2, &(UBLOXM8N_Dev.pvtMsg[0]), 100); //se reciben bloques de 10 bits
	}
//	if (huart == &huart1) //Bluetooth uart idle line detection
//	{
//		HAL_UART_Receive_IT(&huart1, &HC06_Rx_CmdBuffer[0], 6); //se reciben bloques de 6 bits
//	}
}
void HAL_UART_RxCpltCallback(UART_HandleTypeDef *huart)
{
	if (huart == &huart2) //GNSS uart completed PVT message transmission
	{
		UBLOXM8N_processPVTmsg(&UBLOXM8N_Dev);
	}
	if (huart == &huart1) //HC06 full message received, generate events
	{
		if (strncmp((char*)&HC06_Rx_CmdBuffer[0],"HC06-",5) == 0) //checks first 5 characters
		{
			Event_FSM eventTemp;
			switch((char)HC06_Rx_CmdBuffer[5])
			{
			case '0': //Get device info
				eventTemp = BLT_Get_UsrData_Event;
				break;
			case '1': //Set device info
				eventTemp = BLT_Set_UsrData_Event;
				break;
			case '2': //Calib sensors
				//eventTemp = Nothing_Event;
				break;
			case '3': //Erase memory
				eventTemp = BLT_EraseMemory;
				break;
			case '4': //Read memory
				eventTemp = BLT_Get_SensorData_Event;
				break;
			default:
				break;
			}
			fifo_add(queue_FSM, &eventTemp);
		}
	}
}
void HAL_TIM_IC_CaptureCallback(TIM_HandleTypeDef *htim)
{
	if (htim == &htim4) //FM receiver signal PWM measurement
	{
		if (htim->Channel == HAL_TIM_ACTIVE_CHANNEL_1) //rising edge interrupt
		{
			//Calculate DC and frequency
			RCReceiverS.TIM_IC_Val1 = HAL_TIM_ReadCapturedValue(htim, TIM_CHANNEL_1); //rising edge val
			if (RCReceiverS.TIM_IC_Val1 != 0)
			{
				RCReceiverS.TIM_IC_Val2 = HAL_TIM_ReadCapturedValue(htim, TIM_CHANNEL_2); //falling edge val
				RCReceiverS.PWM_DC = (float)RCReceiverS.TIM_IC_Val2*100/RCReceiverS.TIM_IC_Val1;
				RCReceiverS.PWM_f = HAL_RCC_GetPCLK1Freq()/RCReceiverS.TIM_IC_Val1; //tim clock is 2xPCLK1
			}
			else
			{
				RCReceiverS.PWM_DC = 0;
				RCReceiverS.PWM_f = 0;
			}
			//Classify the value
			if ((RCReceiverS.PWM_DC > (RCReceiverS.PWM_DC_Minus100-RCReceiverS.PWM_DC_Thre)) && (RCReceiverS.PWM_DC < (RCReceiverS.PWM_DC_Minus100+RCReceiverS.PWM_DC_Thre)))
			{
				RCReceiverS.current_SwitchPosition = Minus100;
			}
			else if ((RCReceiverS.PWM_DC > (RCReceiverS.PWM_DC_Zero-RCReceiverS.PWM_DC_Thre)) && (RCReceiverS.PWM_DC < (RCReceiverS.PWM_DC_Zero+RCReceiverS.PWM_DC_Thre)))
			{
				RCReceiverS.current_SwitchPosition = Zero;
			}
			else if ((RCReceiverS.PWM_DC > (RCReceiverS.PWM_DC_Plus100-RCReceiverS.PWM_DC_Thre)) && (RCReceiverS.PWM_DC < (RCReceiverS.PWM_DC_Plus100+RCReceiverS.PWM_DC_Thre)))
			{
				RCReceiverS.current_SwitchPosition = Plus100;
			}
			else
			{
				RCReceiverS.current_SwitchPosition = NonValid;
			}

			//Detect change and generate FSM events
			if (RCReceiverS.current_SwitchPosition != RCReceiverS.old_SwitchPosition)
			{
				Event_FSM eventTemp;
				switch (RCReceiverS.old_SwitchPosition)
				{
				case Minus100:
					switch (RCReceiverS.current_SwitchPosition)
					{
					case Plus100:
						eventTemp = Minus100_to_Plus100_Event;
						break;
					case Zero:
						eventTemp = Minus100_to_Zero_Event;
						break;
					case NonValid:
						break;
					default:
						break;
					}
					break;
				case Zero:
					switch (RCReceiverS.current_SwitchPosition)
					{
					case Plus100:
						eventTemp = Zero_to_Plus100_Event;
						break;
					case Minus100:
						eventTemp = Zero_to_Minus100_Event;
						break;
					case NonValid:
						break;
					default:
						break;
					}
					break;
				case Plus100:
					switch (RCReceiverS.current_SwitchPosition)
					{
					case Minus100:
						eventTemp = Plus100_to_Minus100_Event;
						break;
					case Zero:
						eventTemp = Plus100_to_Zero_Event;
						break;
					case NonValid:
						break;
					default:
						break;
					}
					break;
				case NonValid:
					break;
				}
				fifo_add(queue_FSM, &eventTemp);
				RCReceiverS.old_SwitchPosition = RCReceiverS.current_SwitchPosition;
			}
		}
	}
}
/* USER CODE END 4 */
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
