davidlake/RC-Aerobatic-Acquisition-System/(commit log)

2021-08-18 Adding schematic folder
2021-08-21 Adding schematics folders
2021-08-22 Adding KiCad board design folder and files
    [F3A_Board.kicad_pcb, F3A_Board.sch, F3A_Board.step]
2021-08-23 Adding Zener datasheets
    [F3A_Board.kicad_pcb, F3A_Board.sch]
2021-08-23 Changing pin labels
    [F3A_Board.sch]
2021-08-25 Tried power consumption tool
2021-08-25 Not enabling uartidle in ublox init function
2021-08-25 Now uart for HC06 just works with regular interrupts (no idle line)
2021-08-26 PCBnew updated Created step file
    [F3A_Board.kicad_pcb, F3A_Board.step]
2021-08-26 Adding arduino file to simulate PWM from receiver
2021-08-27 Adding assembly drawing and 3D assembly
    [Assembly.step]
2021-08-27 Small change
    [F3A_Board.kicad_pcb]
2021-08-28 Adding Matlab application files
    [Aircraft surface.stl, femur.stl]
2021-08-28 Adding plastic screws docu and links
2021-08-28 Changing things in sumulation of trajectories and sensores
2021-08-31 Adding component steps and drawings
    [Assembly.step, Cap.step, Envelope box.step]
2021-08-31 Update drawings with SLA material (epoxy resin) and xy direciton mark on the cap
    [Assembly.step, Cap.step]
2021-09-01 Improvements on the main application and addition of plane model
    [Gemini.stl]
2021-09-01 Adding simulated sensor file to make trials
2021-09-01 Trying things with the stl representation with patches...
2021-09-04 Change UART HC06 to higher baudrate 921600
2021-09-09 HC06 now controlled with high side switch
    [F3A_Board.sch]
2021-09-09 Adding spice simulation for HC06 high side switch
